pexa-6/Cerberus/Documentation/Hardware Datasheet.md

<div align="center">  
<h1>🐺 Cerberus — Hardware Datasheet</h1> 
</div>
**----------------------------------------------------------**
> Техническая документация аппаратной части проекта Cerberus. Документ описывает текущую принципиальную схему KiCad и служит справочником по питанию, интерфейсам, GPIO, резисторам и конденсаторам.

<div align="center">  
<h2>📌 Общая информация</h2> 
</div>

| **Параметр** | **Значение** |
| :---: | :---: |
| Проект | Cerberus |
| Версия документа | v0.2 |
| Статус | 🟡 Development |
| Основной контроллер | ESP32-S3-N16R8 на плате ESP32-S3-DevKitC |
| Flash | 16 MB |
| PSRAM | 8 MB |
| Логический уровень ESP32-S3 | 3.3 V |
| Основная силовая линия | +5V |
| Линия периферии | +3V3 |
| PCB | Main Board + Power Board — проектируется |
| CAD | KiCad 10 |
| Единицы измерения | mm |
| Монтажные стойки | M3 |
| Grid | 1.27 mm |

> ⚠️ В схеме используется символ `ESP32-S3-DevKitC`, а физическая плата основана на ESP32-S3-N16R8. Питание +3V3 в текущей схеме берётся с вывода 3V3 платы DevKitC; отдельный внешний стабилизатор 3.3 V на этой схеме не показан.

---

<div align="center">  
<h2>🎯 1. Назначение</h2> 
</div>
---
**Cerberus** — портативная embedded-платформа на базе ESP32-S3 с экраном, физическими кнопками, радиомодулями, RFID/NFC, инфракрасным интерфейсом и съёмным накопителем.

**Основные аппаратные узлы:**

- 🧠 ESP32-S3-N16R8 / ESP32-S3-DevKitC
- 📡 2× NRF24L01
- 📻 CC1101
- 🪪 PN532
- 🪪 RDM6300
- 🔴 IR TX на IR LED и транзисторе 2N3904
- 📥 IR RX на VS1838B
- 💾 MicroSD
- 🖥️ TFT 240×320 на ILI9341
- 🎛️ 5 физических кнопок и зуммер
- 🔋 18650 и модуль Power Bank на IP5306
- 🔌 USB и Digispark ATtiny85 как отдельный микроконтроллерный модуль

---

<div align="center">  
<h2>🧠 2. Архитектура питания</h2> 
</div>
---

```text
18650 Battery
     │
     ▼
Power Bank Module / IP5306
     │
     └────────────── +5V
                  │
	   ┌────────────┼────────────┐
       │            │            │
       ▼            ▼            ▼
    ESP32-S3    RDM6300        IR TX
     pin 5V      +5V    +5V → R8 → +5V_LED
       │
       ▼
On-board 3.3 V regulator
       │
       ▼
     +3V3
       │
       ├── NRF24L01 #1
       ├── NRF24L01 #2
       ├── CC1101
       ├── PN532
       ├── MicroSD
       ├── TFT Display
       └── VS1838B IR RX
```

<div align="center">  
<h3>2.1 Линии питания</h3> 
</div>
==================================

|  **Net** | **Напряжение** | **Назначение** |
| :---: | :---: | :---: |
|  `+BATT` | напряжение 18650 | Аккумуляторный держатель, минус батареи подключён к `-BATT` |
| `+BATT_SW` | напряжение 18650 после переключателя | Питание аккумуляторного входа Power Bank Module согласно схеме |
| `+5V` | 5 V | Выход Power Bank Module и питание 5 V потребителей |
| `+5V_LED`  | около 5 V под нагрузкой | Питание анода IR LED через R8 |
| `+3V3` | 3.3 V | Периферия с логикой 3.3 V; в текущей схеме — от вывода 3V3 DevKitC |
| `GND` | 0 V | Общая земля схемы |

> ⚠️ Перед финальной PCB необходимо проверить максимальный суммарный ток периферии и допустимый ток 3.3 V стабилизатора на используемой плате ESP32-S3-DevKitC. Наличие вывода `3V3` само по себе не гарантирует достаточный запас тока для всех радиомодулей одновременно.

---

<div align="center">  
<h2>🧩 3. SPI-архитектура</h2> 
</div>
---
В Cerberus используются **две отдельные SPI-группы**. Дисплей не входит в общую SPI-шину радиомодулей и MicroSD.

<div align="center">  
<h3>3.1 SPI Bus A — периферийная шина</h3> 
</div>
==================================
**Общие сигналы:**

| **Сигнал** | **GPIO ESP32-S3** | **Устройства** |
| :---: | :---: | :---: |
| SCK | GPIO16 | NRF24L01 #1, NRF24L01 #2, CC1101, PN532, MicroSD |
| MOSI | GPIO41 | NRF24L01 #1, NRF24L01 #2, CC1101, PN532, MicroSD |
| MISO | GPIO13 | NRF24L01 #1, NRF24L01 #2, CC1101, PN532, MicroSD |

**У каждого устройства отдельный сигнал выбора:**

| **Устройство** | **CS / CSN / SS** |
| :---: | :---: |
|  NRF24L01 #1 | GPIO48 |
|  NRF24L01 #2 | GPIO18 |
| CC1101 | GPIO38 |
| PN532 | GPIO2 |
| MicroSD | GPIO40 |

<div align="center">  
<h3>3.2 SPI Bus B — TFT Display</h3> 
</div>
==================================
**Экран использует отдельные GPIO для SPI-сигналов:**

| **Сигнал дисплея** | **GPIO / Net** | **Примечание** |
| :---: | :---: | :---: |
| CS | GPIO10 | Выбор дисплея |
| RESET | `RST` | Подключён к сети `RST` на схеме, а не к отдельному GPIO |
| DC | GPIO14 | Выбор команды/данных |
| SDI / MOSI | GPIO11 | Данные к дисплею |
| SCK | GPIO12 | Тактирование дисплея |
|  LED / Backlight | GPIO15 через R3 = 100 Ω | Управление подсветкой согласно схеме |
| SDO / MISO | NC | Не подключён в текущей схеме |

Сенсорные линии модуля дисплея (`T_CLK`, `T_CS`, `T_DIN`, `T_DO`, `T_IRQ`) на текущей схеме отмечены как `NC`. Следовательно, резистивный touch-контроллер пока электрически не подключён.

> ⚠️ Не объединять GPIO11/GPIO12 дисплея с GPIO41/GPIO16 периферийной SPI-шины без отдельного изменения схемы и проверки прошивки.

---

<div align="center">  
<h2>🧠 4. ESP32-S3-N16R8</h2> 
</div>
---

| **Параметр** | **Значение** |
| :---: | :---: |
| Назначение | Главный контроллер Cerberus |
| Flash | 16 MB |
| PSRAM | 8 MB |
| Логический уровень GPIO | 3.3 V |
| Питание платы | `+5V` на вывод 5V DevKitC |
| Выход периферийного питания | `+3V3` с вывода 3V3 DevKitC |
| USB | USB-подключение платы для питания/прошивки/отладки согласно используемой DevKitC |

Контроллер отвечает за интерфейс пользователя, кнопки, работу радиомодулей, IR TX/RX, RFID/NFC, MicroSD и управление состоянием устройства.

---

<div align="center">  
<h2>📡 5. NRF24L01</h2> 
</div>
---
Количество: **2 модуля**.

### Питание и шина

```text
VCC  → +3V3
GND  → GND
SCK  → GPIO16
MOSI → GPIO41
MISO → GPIO13
```

### Линии управления

| **Сигнал** | **NRF24L01 #1** | **NRF24L01 #2** |
| :---: | :---: | :---: |
| CE | GPIO17 | GPIO21 |
| CSN | GPIO48 | GPIO18 |
| IRQ | NC | NC |

### Локальная развязка

| **Ref** | **Номинал** | **Подключение** | **Назначение** |
| :-----: | :---: | :---: | :---: |
| C3 | 22 µF | +3V3 ↔ GND | Объёмная развязка NRF24 #1 |
| C4 | 100 nF | +3V3 ↔ GND | Керамическая высокочастотная развязка NRF24 #1 |
| C5 | 22 µF | +3V3 ↔ GND | Объёмная развязка NRF24 #2 |
| C6 | 100 nF | +3V3 ↔ GND | Керамическая высокочастотная развязка NRF24 #2 |

Конденсаторы C3/C4 и C5/C6 должны располагаться около питания соответствующего модуля. Особенно важно сделать коротким путь от керамического конденсатора к VCC и GND модуля.

---

<div align="center">  
<h2>📻 6. CC1101</h2> 
</div>
---
### Подключение

| **Сигнал** | **GPIO / Net** |
| :---: | :---: |
| VCC | +3V3 |
| GND | GND |
| SCK | GPIO16 |
| MOSI | GPIO41 |
| MISO | GPIO13 |
| CSN | GPIO38 |
| GDO0 | GPIO39 |
| GDO2 | NC |

### Локальная развязка

| **Ref** | **Номинал** | **Подключение** | **Назначение** |
| :-----: | :---: | :---: | :---: |
| C7 | 10 µF | +3V3 ↔ GND | Объёмная развязка CC1101 |
| C8 | 100 nF | +3V3 ↔ GND | Керамическая высокочастотная развязка CC1101 |

---

<div align="center">  
<h2>🪪 7. PN532</h2> 
</div>
---
В текущей схеме PN532 работает по **SPI**. I²C-контакты, показанные на дополнительном разъёме модуля, отмечены как `NC`.

| **Сигнал** | **GPIO / Net** |
| :---: | :---: |
| VCC | +3V3 |
| GND | GND |
| SCK | GPIO16 |
| MOSI | GPIO41 |
| MISO | GPIO13 |
|  SS / CS | GPIO2 |
| IRQ | NC |
| RSTO | NC |

### Локальная развязка

| **Ref** | **Номинал** | **Подключение** | **Назначение** |
| :-----: | :---: | :---: | :---: |
| C9 | 10 µF | +3V3 ↔ GND | Объёмная развязка PN532 |
| C10 | 100 nF | +3V3 ↔ GND | Керамическая высокочастотная развязка PN532 |

> Перед запуском проверь переключатель режима конкретного модуля PN532: он должен быть выставлен в SPI. Не считать выводы IRQ/RSTO подключёнными — в текущей схеме они не используются.

---

<div align="center">  
<h2>💾 8. MicroSD</h2> 
</div>
---
Интерфейс: SPI Bus A.

| **Сигнал** | **GPIO / Net** |
| :---: | :---: |
| VCC | +3V3 |
| GND | GND |
| SCK | GPIO16 |
| MOSI | GPIO41 |
| MISO | GPIO13 |
| CS | GPIO40 |

### Локальная развязка

| **Ref** | **Номинал** | **Подключение** | **Назначение** |
| :-----: | :---: | :---: | :---: |
| C13 | 47 µF | +3V3 ↔ GND | Локальный запас энергии на линии MicroSD |
| C14 | 100 nF | +3V3 ↔ GND | Керамическая высокочастотная развязка MicroSD |

---

<div align="center">  
<h2>🖥️ 9. TFT Display — ILI9341</h2> 
</div>
---

| **Параметр** | **Значение** |
| :---: | :---: |
| Разрешение | 240 × 320 |
| Интерфейс дисплея  | Отдельная SPI Bus B |
| Контроллер дисплея | ILI9341 |
| Питание | +3V3 |
| Земля | GND |

### Подключение дисплея

| **Контакт** | **Подключение** |
| :---: | :---: |
| VCC | +3V3 |
| GND | GND |
| CS | GPIO10 |
| RESET | `RST` |
| DC | GPIO14 |
| SDI / MOSI | GPIO11 |
| SCK | GPIO12 |
| LED / Backlight | GPIO15 через R3 = 100 Ω |
| SDO / MISO | NC |
| T_CLK, T_CS, T_DIN, T_DO, T_IRQ | NC |

### Конденсаторы дисплея

| **Ref** | **Номинал** | **Подключение** | **Назначение** |
| :-----: | :---: | :---: | :---: |
| C1 | 10 µF | +3V3 ↔ GND | Объёмная развязка питания дисплея |
| C2 | 100 nF | +3V3 ↔ GND | Керамическая высокочастотная развязка дисплея |

> ⚠️ Линия `RESET` на чертеже подключена к сети `RST`. Перед изготовлением платы проверь, что это действительно ожидаемое поведение для выбранного TFT-модуля. Если требуется независимый сброс дисплея, понадобится отдельный GPIO.
>
> ⚠️ GPIO15 через R3 управляет входом подсветки. Перед финальной разводкой проверь документацию своего TFT-модуля: у некоторых плат уже есть собственный ограничитель тока подсветки.

---

<div align="center">  
<h2>🪪 10. RDM6300</h2> 
</div>
---
### Питание и UART

| **Сигнал**  | **Подключение** |
| :---: | :---: |
| VCC | +5V |
| GND | GND |
| TX | Через делитель R4/R5 на GPIO42 |
| RX | NC в текущей схеме |
| ANT1 / ANT2 | NC на схеме; используется антенна/катушка самого модуля согласно его конструкции |

### Согласование уровня TX

```text
RDM6300 TX
    │
  R4 1 kΩ
    │
    ├──────── GPIO42
    │
  R5 2 kΩ
    │
   GND
```

Если высокий уровень TX равен 5 V, идеальный расчёт делителя даёт:

`VGPIO = 5 V × 2 kΩ / (1 kΩ + 2 kΩ) ≈ 3.33 V`

Это позволяет снизить уровень сигнала до диапазона GPIO ESP32-S3. Перед подключением всё равно нужно подтвердить реальный уровень сигнала TX на используемом модуле.

### Конденсаторы в области +5V

| **Ref** | **Номинал** | **Подключение** | **Область схемы** |
| :-----: | :---: | :---: | :---: |
| C11 | 100 nF | +5V ↔ GND | Узел +5V рядом с RDM6300 |
| C12 | 100 nF | +5V ↔ GND | Узел +5V рядом с RDM6300 |

На схеме C11 и C12 находятся в одной области силовой линии +5V. Их окончательное физическое размещение следует подтвердить при разводке PCB, а не копировать только по положению символов на листе.

---

<div align="center">  
<h2>🔴 11. IR TX — передатчик инфракрасного сигнала</h2> 
</div>
---
IR LED управляется отдельным NPN-транзистором **Q1 = 2N3904**. Транзистор работает как нижний ключ (low-side switch).

### Цепь IR LED

```text
+5V ── R8 33 Ω ── +5V_LED ── D1 Anode
			D1 Cathode ── Q1 Collector
```

### Управление транзистором

```text
ESP32-S3 GPIO47 ── R6 330 Ω ── Q1 Base
                               │
                            R7 10 kΩ
                               │
                              GND

Q1 Emitter ── GND
```

| **Ref** | **Компонент** | **Назначение** |
| :-----: | :---: | :---: |
| D1 | IR LED TX | Инфракрасный светодиод |
| Q1 | 2N3904 | Нижний ключ для IR LED |
| R6 | 330 Ω | Ограничение тока базы от GPIO47 |
| R7 | 10 kΩ | Подтяжка базы к GND, удерживает транзистор закрытым при старте |
| R8 | 33 Ω | Последовательный резистор между +5V и линией +5V_LED |
| C17 | 100 µF | Объёмная ёмкость в области питания IR TX |
| C18 | 100 nF | Керамическая развязка линии +5V в области IR TX |

### Важная проверка выводов 2N3904

По символу `Q1` на текущей схеме KiCad:

| **Номер вывода символа** | **Подключение на схеме** | **Функция для показанного символа** |
| :---: | :---: | :---: |
| 1 | GND | Emitter |
| 2 | Узел GPIO47/R6/R7 | Base |
| 3 | Катод D1 / net `Q1` | Collector |

**Перед изготовлением PCB обязательно проверь pinout именно того корпуса 2N3904, который будешь покупать, и сопоставь его с footprint KiCad.** Нумерацию выводов нельзя переносить по памяти с другого транзистора или корпуса.

> R8 = 33 Ω задаёт ток цепи IR LED вместе с прямым напряжением светодиода и падением напряжения на транзисторе. Перед длительной передачей проверь расчётный ток и допустимую мощность резистора по характеристикам конкретного IR LED.

---

<div align="center">  
<h2>📥 12. IR RX — приёмник VS1838B</h2> 
</div>
---

| **Контакт** | **Подключение** |
| :---: | :---: |
| VCC | +3V3 |
| GND | GND |
| OUT | GPIO1 через R2 = 100 Ω |

### Развязка питания

| **Ref** | **Номинал** | **Подключение** | **Назначение** |
| :-----: | :---: | :---: | :---: |
| C15 | 4.7 µF | +3V3 ↔ GND | Локальная объёмная развязка VS1838B |
| C16 | 100 nF | +3V3 ↔ GND | Керамическая высокочастотная развязка VS1838B |

R2 = 100 Ω стоит последовательно в сигнальной линии OUT перед GPIO1.

---

<div align="center">  
<h2>🧷 13. Digispark ATtiny85</h2> 
</div>
---
На плате предусмотрен отдельный модуль **Digispark ATtiny85**.

- Это самостоятельный микроконтроллерный модуль, не второй процессор ESP32.
- В текущей схеме его сигнальные выводы отмечены как `NC` — связи с GPIO ESP32-S3 и периферийной SPI-шиной не предусмотрены.
- Планируемое назначение — отдельные эксперименты с USB HID и автоматизацией ввода в собственной тестовой среде.
- USB-подключение Digispark не следует считать подключённым через ESP32-S3: его путь питания/USB должен рассматриваться отдельно от основной схемы Cerberus.

> Если позже решишь подключить какие-либо выводы ATtiny85 к основной плате, сначала добавь конкретные net labels, уровни питания и назначение каждого сигнала в KiCad и обнови этот документ.

---

<div align="center">  
<h2>🎛️ 14. Кнопки и зуммер</h2> 
</div>
---
### Кнопки

Пять кнопок подключаются между GPIO и GND. Для такого включения в прошивке обычно используется `INPUT_PULLUP`, если внешние подтягивающие резисторы не добавлены отдельно.

| **Кнопка** | **GPIO** | **Состояние при нажатии** |
| :---: | :---: | :---: |
| UP |  GPIO4 | LOW |
| DOWN |  GPIO5 | LOW |
| LEFT |  GPIO6 | LOW |
| RIGHT |  GPIO7 | LOW |
| OK |  GPIO8 | LOW |

### Зуммер

| **Узел** | **Подключение** |
| :---: | :---: |
| Сигнал зуммера | GPIO9 через R1 = 100 Ω |
| Второй контакт | GND |
| R1 | 100 Ω последовательно с управляющим сигналом |

> Перед постоянной работой проверь ток и тип зуммера. Если это зуммер с высоким током потребления, управлять им непосредственно от GPIO нельзя — потребуется транзисторный драйвер. R1 сам по себе не заменяет драйвер.

---

<div align="center">  
<h2>🔋 15. Аккумулятор и Power Bank Module</h2> 
</div>
---

| **Узел** | **Подключение по схеме** |
| :---: | :---: |
| Держатель 18650 `BAT+` | `+BATT` |
| Держатель 18650 `BAT−` | `-BATT` |
|  Вход питания модуля | `+BATT_SW` / `-BATT` согласно переключателю на схеме |
| Выход 5 V модуля | `+5V` и GND |
| ESP32-S3-DevKitC | 5V pin → +5V; 3V3 pin → +3V3 rail |

Перед сборкой перепроверь контакты `BAT+`, `BAT−`, выход 5 V и положение переключателей по фактической плате Power Bank Module. Не подключай 18650 напрямую к линии +5V.

---

<div align="center">  
<h2>🧮 16. Полный список конденсаторов</h2> 
</div>
---
Эта таблица сводит **все конденсаторы C1–C22, показанные на текущей схеме**. Номинал и net взяты с чертежа; назначение описывает планируемую функцию и не заменяет проверку после разводки.

| **Ref** | **Номинал** | **Линия**  | **Область / модуль** | **Тип для сборки** |
| :-----: | :---: | :---: | :---: | :---: |
| C1 | 10 µF | +3V3 ↔ GND | TFT Display | Полярный bulk-конденсатор; проверить выбранный корпус/BOM |
| C2 | 100 nF | +3V3 ↔ GND | TFT Display | Керамический, неполярный |
| C3 | 22 µF | +3V3 ↔ GND | NRF24L01 #1 | Полярный bulk-конденсатор |
| C4 | 100 nF | +3V3 ↔ GND | NRF24L01 #1 | Керамический, неполярный |
| C5 | 22 µF | +3V3 ↔ GND | NRF24L01 #2 | Полярный bulk-конденсатор |
| C6 | 100 nF | +3V3 ↔ GND | NRF24L01 #2 | Керамический, неполярный |
| C7 | 10 µF | +3V3 ↔ GND | CC1101 | Полярный bulk-конденсатор |
| C8 | 100 nF | +3V3 ↔ GND | CC1101 | Керамический, неполярный |
| C9 | 10 µF | +3V3 ↔ GND | PN532 | Полярный bulk-конденсатор |
| C10 | 100 nF | +3V3 ↔ GND | PN532 | Керамический, неполярный |
| C11 | 100 nF | +5V ↔ GND  | Узел +5V, область RDM6300 | Керамический, неполярный |
| C12 | 100 nF | +5V ↔ GND  | Узел +5V, область RDM6300 | Керамический, неполярный |
| C13 | 47 µF | +3V3 ↔ GND | MicroSD | Полярный bulk-конденсатор |
| C14 | 100 nF | +3V3 ↔ GND | MicroSD | Керамический, неполярный |
| C15 | 4.7 µF | +3V3 ↔ GND | VS1838B / IR RX | Полярный bulk-конденсатор |
| C16 | 100 nF | +3V3 ↔ GND | VS1838B / IR RX | Керамический, неполярный |
| C17 | 100 µF | +5V ↔ GND  | Узел питания IR TX | Полярный bulk-конденсатор |
| C18 | 100 nF | +5V ↔ GND  | Узел питания IR TX | Керамический, неполярный |
| C19 | 470 µF | +5V ↔ GND  | Главная линия +5V возле ESP32-S3 | Полярный bulk-конденсатор |
| C20 | 100 nF | +5V ↔ GND  | Главная линия +5V возле ESP32-S3 | Керамический, неполярный |
| C21 | 100 nF | +3V3 ↔ GND | Линия +3V3 возле ESP32-S3 | Керамический, неполярный |
| C22 | 100 nF | +3V3 ↔ GND | Линия +3V3 возле ESP32-S3 | Керамический, неполярный |

<div align="center">  
<h3>16.1 Правила установки конденсаторов</h3> 
</div>
==================================
- Керамический `100 nF` устанавливай максимально близко к питанию соответствующего модуля; соединения VCC–C–GND должны быть короткими.
- Bulk-конденсатор `4.7–470 µF` располагается рядом с модулем/ветвью питания, которой он помогает.
- Полярный конденсатор: `+` к положительной линии, `−` к GND. Перед пайкой проверь метку минуса на корпусе.
- Керамические конденсаторы неполярные.
- Электрическое подключение в каждой паре параллельное: оба конденсатора идут между одной линией питания и GND, а не последовательно друг с другом.
- Положение символов на принципиальной схеме не задаёт реальное расстояние на PCB. Размещай детали физически у выводов питания конкретного модуля.
- Номиналы в этой таблице отражают текущую схему Cerberus. До заказа платы их следует сверить с datasheet модулей и финальной BOM.

==================================

---

<div align="center">  
<h2>🧮 17. Полный список резисторов</h2> 
</div>
---

| **Ref** | **Номинал** | **Подключение** | **Назначение** |
| :-----: | :---: | :---: | :---: |
| R1 | 100 Ω | GPIO9 → зуммер |  Последовательный резистор управляющей линии зуммера  |
| R2 | 100 Ω | VS1838B OUT → GPIO1 | Последовательный резистор сигнала IR RX |
| R3 | 100 Ω | GPIO15 → LED/Backlight TFT | Последовательный резистор управляющей линии подсветки |
| R4 | 1 kΩ |  RDM6300 TX → узел GPIO42  | Верхний резистор делителя уровня UART |
| R5 | 2 kΩ | Узел GPIO42 → GND | Нижний резистор делителя уровня UART |
| R6 | 330 Ω | GPIO47 → база Q1 | Ограничение тока базы 2N3904 |
| R7 | 10 kΩ | База Q1 → GND | Подтяжка базы к GND / pull-down |
| R8 | 33 Ω | +5V → +5V_LED | Последовательный резистор в цепи питания IR LED |

> Номиналы R1–R8 перепроверить по фактическим компонентам перед сборкой. Особенно важны мощность R8 и ток IR LED, pinout Q1 и ток зуммера.

---

<div align="center">  
<h2>🧠 18. GPIO Allocation</h2> 
</div>
---

| **GPIO** | **Назначение** | **Интерфейс / цепь** | **Статус по схеме** |
| :---: | :---: | :---: | :---: |
|  GPIO1 | IR RX | VS1838B OUT через R2 = 100 Ω | Подключён |
|  GPIO2 | PN532 CS / SS | SPI Bus A | Подключён |
|  GPIO4 | UP | Кнопка на GND | Подключён |
|  GPIO5 | DOWN | Кнопка на GND | Подключён |
|  GPIO6 | LEFT | Кнопка на GND | Подключён |
|  GPIO7 | RIGHT | Кнопка на GND | Подключён |
|  GPIO8 | OK | Кнопка на GND | Подключён |
|  GPIO9 | Buzzer | Через R1 = 100 Ω | Подключён |
|  GPIO10  | TFT CS | SPI Bus B | Подключён |
|  GPIO11  | TFT SDI / MOSI | SPI Bus B | Подключён |
|  GPIO12  | TFT SCK | SPI Bus B | Подключён |
|  GPIO13  | MISO | SPI Bus A | Подключён |
|  GPIO14  | TFT DC | Управление дисплеем | Подключён |
|  GPIO15  | TFT LED / Backlight | Через R3 = 100 Ω | Подключён |
|  GPIO16  | SCK | SPI Bus A | Подключён |
|  GPIO17  | NRF24L01 #1 CE | Управление радио | Подключён |
|  GPIO18  | NRF24L01 #2 CSN | SPI CS | Подключён |
|  GPIO21  | NRF24L01 #2 CE | Управление радио | Подключён |
|  GPIO38  | CC1101 CSN | SPI CS | Подключён |
|  GPIO39  | CC1101 GDO0 | Digital | Подключён |
|  GPIO40  | MicroSD CS | SPI CS | Подключён |
|  GPIO41  | MOSI | SPI Bus A | Подключён |
|  GPIO42  | RDM6300 TX | Через делитель R4/R5 | Подключён |
|  GPIO47  | IR TX | Через R6 = 330 Ω на базу Q1  | Подключён |
|  GPIO48  | NRF24L01 #1 CSN | SPI CS | Подключён |

<div align="center">  
<h2>18.1 Сигналы, которые сейчас не используются</h2> 
</div>
==================================
- IRQ у обоих NRF24L01.
- GDO2 CC1101.
- IRQ и RSTO PN532.
- SDO/MISO TFT и все touch-сигналы TFT.
- RX RDM6300.
- Выводы Digispark ATtiny85, отмеченные NC на текущей схеме.

==================================

---

<div align="center">  
<h2>📐 19. Правила PCB</h2> 
</div>
---
### Питание и земля

- Делай короткими пути от каждого конденсатора `100 nF` до VCC/GND соответствующего модуля.
- Для полярных конденсаторов обязательно обозначь полярность на шелкографии.
- Проверь ширину дорожек +5V и GND по максимальному току.
- Следи за допустимым током линии +3V3, получаемой с DevKitC.
- Ветка IR LED несёт импульсный ток; не прокладывай её так, чтобы она создавала лишние помехи в чувствительных сигнальных цепях.

### SPI

- SPI Bus A (`GPIO16`, `GPIO41`, `GPIO13`) — NRF24, CC1101, PN532, MicroSD.
- SPI Bus B (`GPIO12`, `GPIO11`) — только TFT-дисплей в текущей версии схемы.
- Каждое SPI-устройство на Bus A имеет собственный CS/CSN/SS.
- Не подключай одновременно выходы MISO нескольких устройств, если их CS не обеспечивает корректное отключение выхода.

### RF

- Располагай радиомодули так, чтобы антеннам хватало свободного пространства.
- Соблюдай ограничения производителя модуля по меди и компонентам под антенной.
- Старайся отделять антенны и RF-часть от импульсных силовых цепей и линий IR TX.

---

<div align="center">  
<h2>🧪 20. Hardware Testing</h2> 
</div>
---
Статус здесь отражает только уже проведённые тесты и известные результаты; он не равен полной проверке всей функции модуля.

| **Модуль** | **Проверка** | **Статус** |
| :---: | :---: | :---: |
| ESP32-S3 | Boot / USB / Serial | 🟢 Проверено |
| TFT ILI9341 | Вывод изображения | 🟢 Проверено |
| Кнопки | Ввод в прошивке | 🟢 Проверено |
| NRF24L01 #1 | SPI-инициализация | 🟢 Проверено |
| NRF24L01 #2 | SPI-инициализация | 🟢 Проверено |
| CC1101 | Чтение регистров | 🟡 Требует повторной проверки: раньше ответа не было |
| PN532 | SPI / чтение карты | 🟢 Проверено |
| RDM6300 | UART / RFID | 🟢 Проверено |
| IR TX | Включение драйвера | 🟢 Проверено |
| IR RX | Получение сигнала | 🟢 Проверено |
| MicroSD | Чтение / запись | 🟢 Проверено |
| Зуммер | Звуковой сигнал | 🟢 Проверено |
| Digispark ATtiny85 | Отдельная работа | ⚪ Не относится к связям ESP32 на текущей схеме |
| Power Bank / силовые линии | Работа под максимальной нагрузкой | 🟡 Требуется измерить токи и просадки напряжения |

---

<div align="center">  
<h2>📋 21. Hardware Status</h2> 
</div>
---
### 🟢 Подключения, отражённые на схеме

- Основной ESP32-S3-DevKitC / ESP32-S3-N16R8.
- Отдельная SPI Bus A для NRF24, CC1101, PN532 и MicroSD.
- Отдельная SPI Bus B для TFT.
- IR TX на 2N3904 с R6 = 330 Ω, R7 = 10 kΩ и R8 = 33 Ω.
- IR RX на VS1838B с R2 = 100 Ω.
- RDM6300 с делителем R4 = 1 kΩ / R5 = 2 kΩ.
- 5 кнопок и зуммер.
- Конденсаторы C1–C22 и резисторы R1–R8 внесены в таблицы этого документа.

### 🟡 Требует проверки до изготовления PCB

- Максимальный суммарный ток линии +3V3.
- Распиновка и footprint конкретного 2N3904.
- Ток IR LED и рассеиваемая мощность R8 = 33 Ω.
- Нужен ли отдельный GPIO для RESET TFT вместо сети `RST`.
- Подсветка TFT с учётом наличия/отсутствия штатного резистора на самом модуле.
- Физическое расположение C11/C12 и других конденсаторов на PCB.
- Успешная работа CC1101, PN532 и MicroSD в окончательной сборке.

---

<div align="center">  
<h2>📚 22. References</h2> 
</div>
---
Для финального уточнения параметров использовать datasheet именно тех модулей и компонентов, которые установлены в Cerberus:

- ESP32-S3-DevKitC / ESP32-S3-N16R8 documentation
- ESP32-S3 Datasheet и Hardware Design Guidelines
- NRF24L01(+) Datasheet
- CC1101 Datasheet
- PN532 User Manual / Datasheet
- RDM6300 module documentation
- ILI9341 Datasheet и документация платы TFT
- VS1838B Datasheet
- MicroSD card/module documentation
- 2N3904 Datasheet для конкретного производителя и корпуса
- IP5306 / Power Bank Module documentation

---

<div align="center">  
<h2>🔄 23. Revision History</h2> 
</div>
---

| **Версия** | **Дата** | **Изменения** |
| --- | --- | --- |
| v0.1 | 2026-10-07 | Первичная версия документа |
| v0.2 | 2026-10-11 | Разделены SPI Bus A и SPI Bus B; обновлены TFT, PN532, Digispark ATtiny85, IR TX на 2N3904; добавлены C1–C22 и R1–R8 по текущей схеме KiCad |

---

**----------------------------------------------------------**
