pexa-6/Cerberus/Documentation/Firmware Documentation.md

<div align="center">  
<h1>🐺 Cerberus — Firmware Documentation</h1> 
</div>
**----------------------------------------------------------**

---

---

**----------------------------------------------------------**
