pexa-6/Cerberus/Test/Art.png

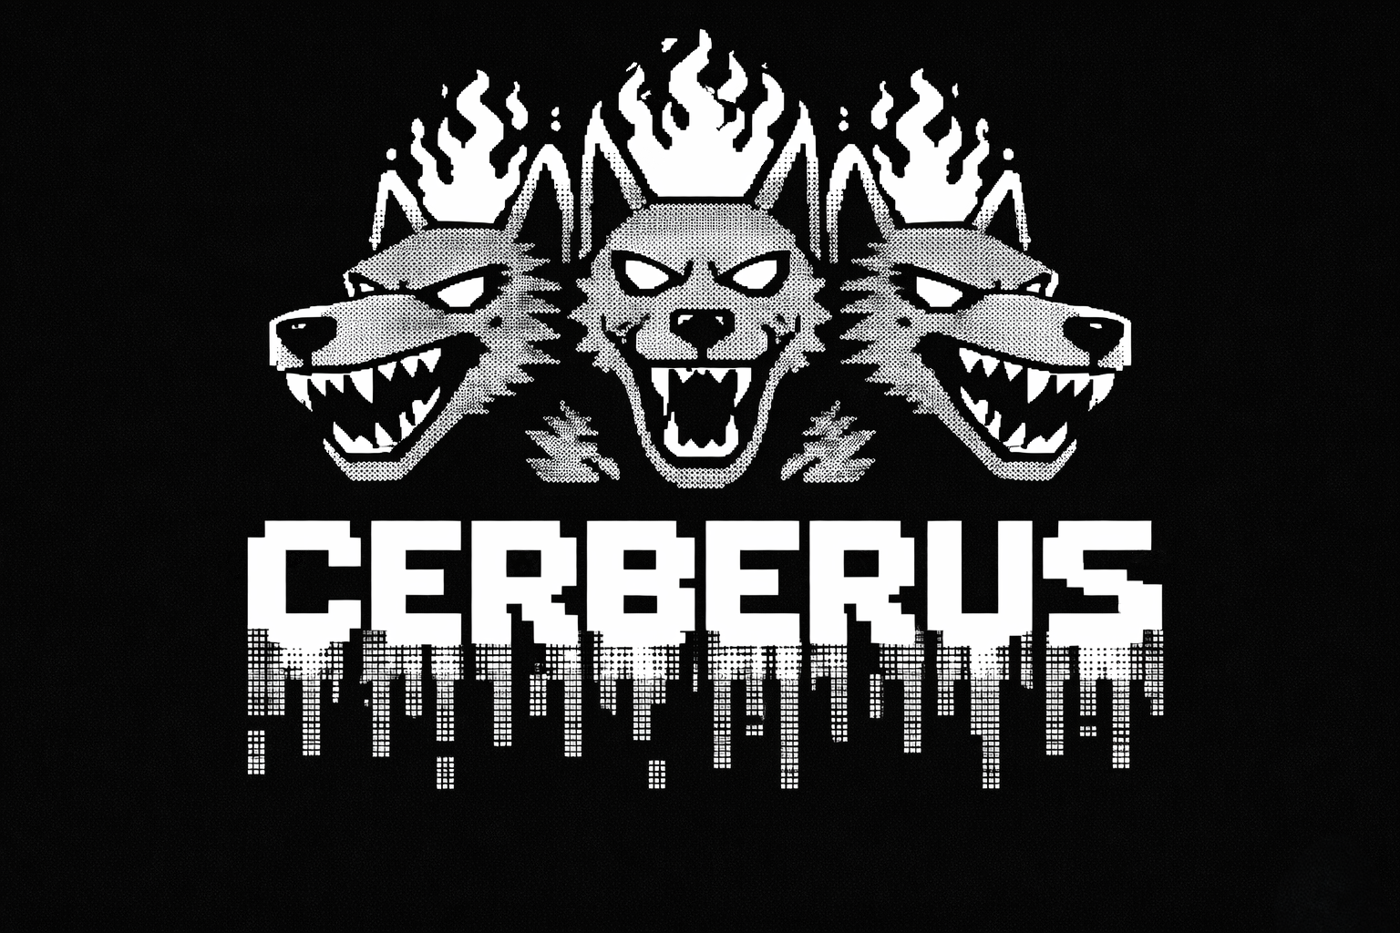
Test/Art.png
