pexa-6/Cerberus/Test/Cerberus.png

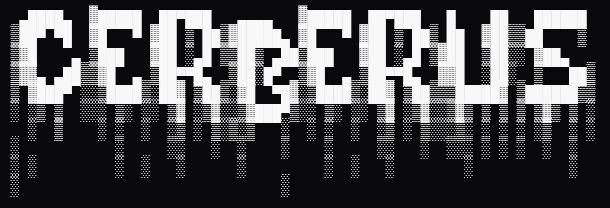
Test/Cerberus.png
