pexa-6/Cerberus/KiCad/Cerberus.kicad_sch

## KiCad design KiCad/Cerberus.kicad_sch (2026-10-11)

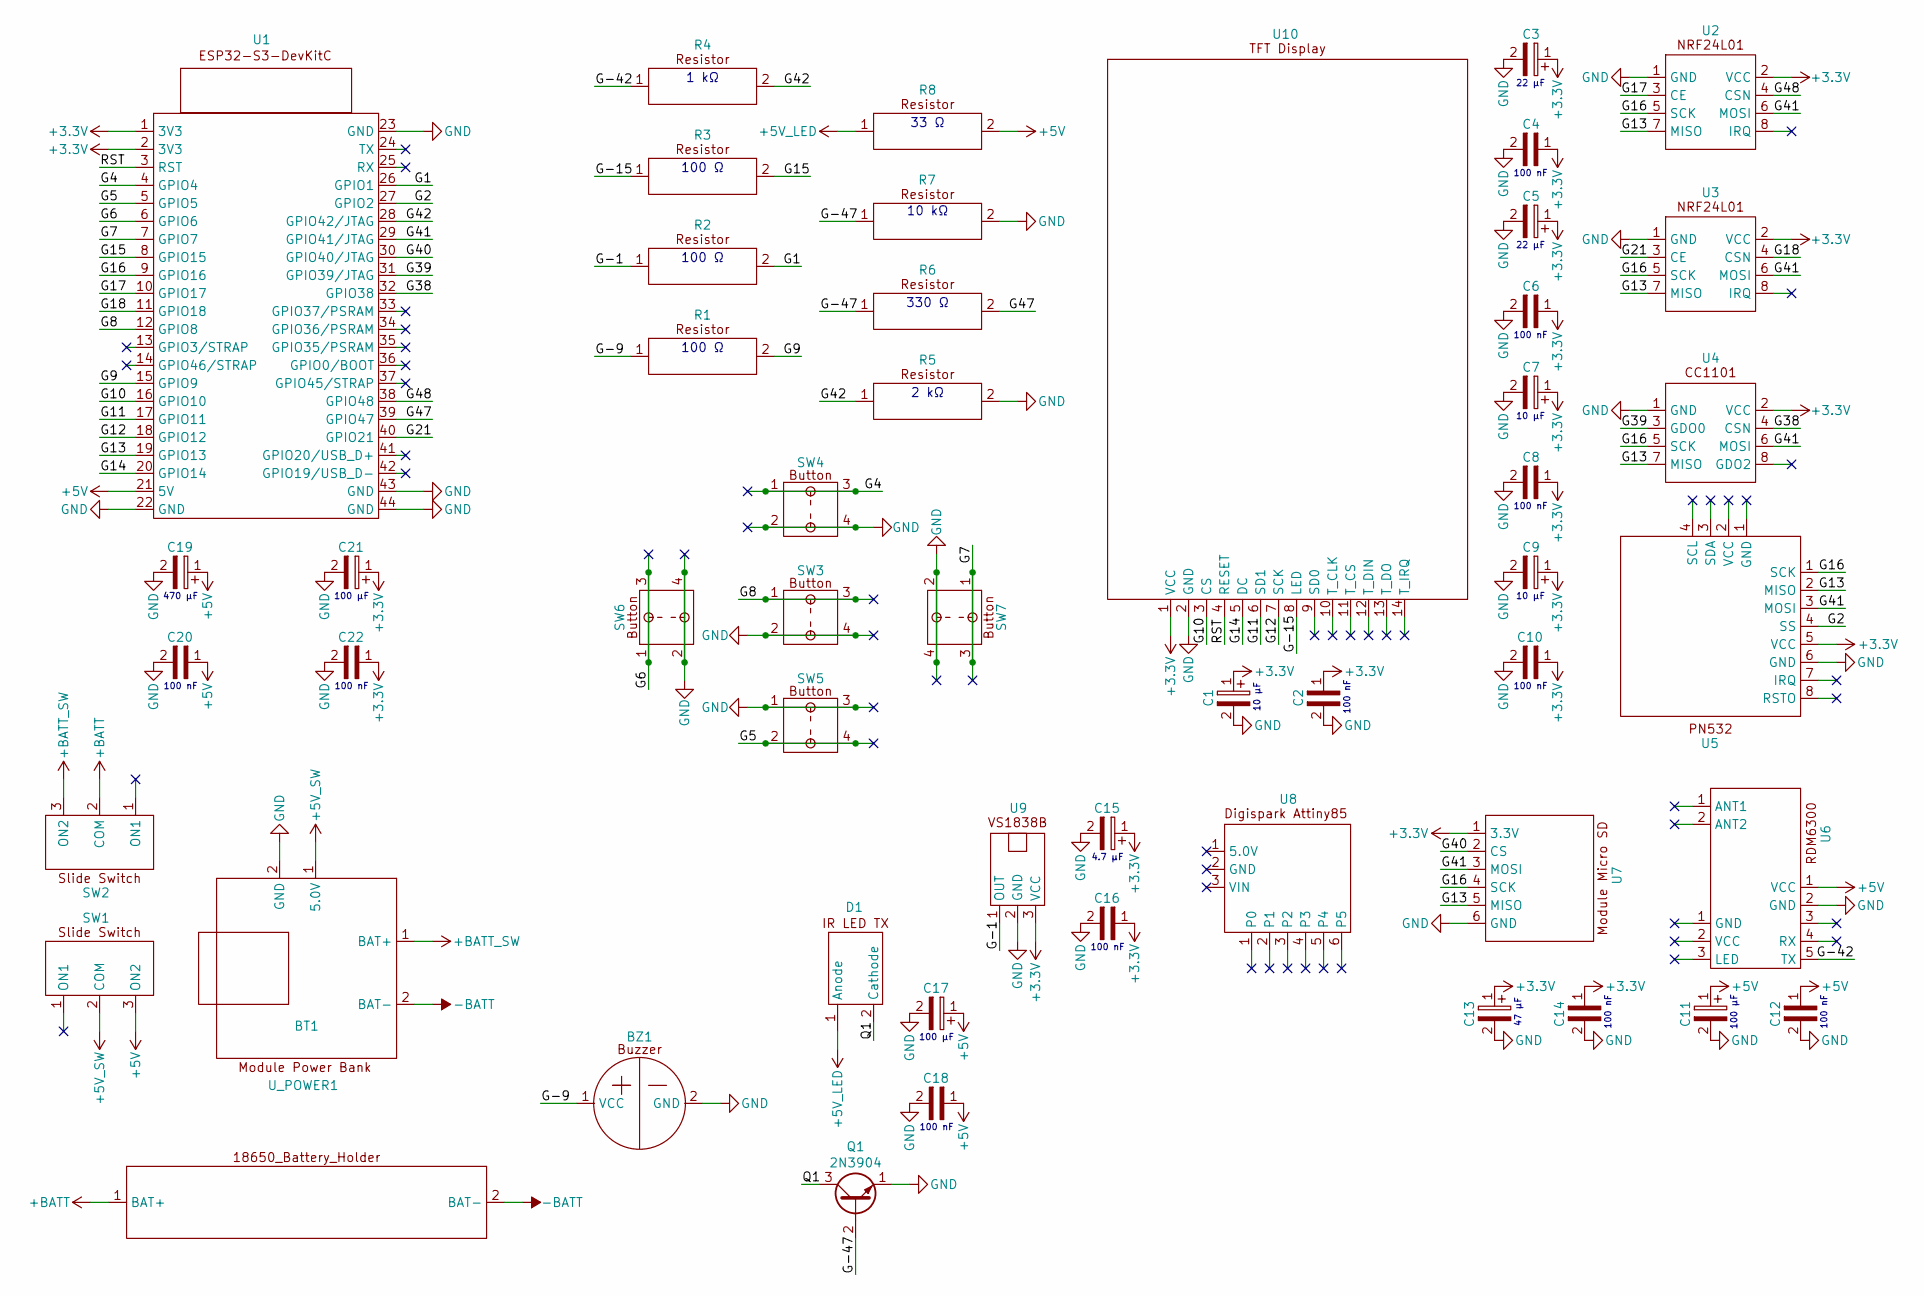
[picture p3: schematic Cerberus.kicad_sch]

Parts:
BT1: 18650_Battery_Holder
BZ1: Buzzer
C1, C3, C5, C7, C9, C11, C13, C15, C17, C21: C_Electrolytic
C2, C4, C6, C8, C10, C12, C14, C16, C18, C20, C22: C_Ceramic
C19: C_Electrolytic_470
D1: IR_LED_TX
Q1: 2N3904; TO-92_Inline
R1, R2, R3, R4, R5, R6, R7, R8: Resistor
SW1, SW2: Slide_Switch
SW3, SW4, SW5, SW6, SW7: Button
U1: ESP32-S3-DevKitC
U2, U3: NRF24L01
U4: CC1101
U5: PN532
U6: RDM6300
U7: Module_Micro_SD
U8: Digispark_Attiny85
U9: VS1838B
U10: TFT_Display
U_POWER1: Module_Power_Bank

Connections:
+3.3V: C1.1, C2.1, C3.1, C4.1, C5.1, C6.1, C7.1, C8.1, C9.1, C10.1, C13.1, C14.1, C15.1, C16.1, C21.1, C22.1, U1.1 (3V3), U1.2 (3V3), U2.2 (VCC), U3.2 (VCC), U4.2 (VCC), U5.5 (VCC), U7.1 (3.3V), U9.3 (VCC), U10.1 (VCC)
+5V: C11.1, C12.1, C17.1, C18.1, C19.1, C20.1, R8.2, SW1.3 (ON2), U1.21 (5V), U6.1 (ANT1)
+5V_LED: D1.1 (Anode), R8.1
+5V_SW: SW1.2 (COM), U_POWER1.1 (5.0V)
+BATT: BT1.1 (BAT+), SW2.2 (COM)
+BATT_SW: SW2.3 (ON2), U_POWER1.1 (5.0V)
-BATT: BT1.2 (BAT-), U_POWER1.2 (GND)
G1: R2.2, U1.26 (GPIO1)
G2: U1.27 (GPIO2), U5.4 (SCL)
G4: SW4.1, SW4.3, U1.4 (GPIO4)
G5: SW5.2, SW5.4, U1.5 (GPIO5)
G6: SW6.1, SW6.3, U1.6 (GPIO6)
G7: SW7.1, SW7.3, U1.7 (GPIO7)
G8: SW3.1, SW3.3, U1.12 (GPIO8)
G9: R1.2, U1.15 (GPIO9)
G10: U1.16 (GPIO10), U10.3 (CS)
G11: U1.17 (GPIO11), U10.6 (SD1)
G12: U1.18 (GPIO12), U10.7 (SCK)
G13: U1.19 (GPIO13), U2.7 (MISO), U3.7 (MISO), U4.7 (MISO), U5.2 (VCC), U7.5 (MISO)
G14: U1.20 (GPIO14), U10.5 (DC)
G15: R3.2, U1.8 (GPIO15)
G16: U1.9 (GPIO16), U2.5 (SCK), U3.5 (SCK), U4.5 (SCK), U5.1 (GND), U7.4 (SCK)
G17: U1.10 (GPIO17), U2.3 (CE)
G18: U1.11 (GPIO18), U3.4 (CSN)
G21: U1.40 (GPIO21), U3.3 (CE)
G38: U1.32 (GPIO38), U4.4 (CSN)
G39: U1.31 (GPIO39/JTAG), U4.3 (GDO0)
G40: U1.30 (GPIO40/JTAG), U7.2 (CS)
G41: U1.29 (GPIO41/JTAG), U2.6 (MOSI), U3.6 (MOSI), U4.6 (MOSI), U5.3 (SDA), U7.3 (MOSI)
G42: R4.2, R5.1, U1.28 (GPIO42/JTAG)
G47: R6.2, U1.39 (GPIO47)
G48: U1.38 (GPIO48), U2.4 (CSN)
G-1: R2.1, U9.1 (OUT)
G-9: BZ1.1 (VCC), R1.1
G-15: R3.1, U10.8 (LED)
G-42: R4.1, U6.5 (TX)
G-47: Q1.2 (B), R6.1, R7.1
GND: BZ1.2 (GND), C1.2, C2.2, C3.2, C4.2, C5.2, C6.2, C7.2, C8.2, C9.2, C10.2, C11.2, C12.2, C13.2, C14.2, C15.2, C16.2, C17.2, C18.2, C19.2, C20.2, C21.2, C22.2, Q1.1 (E), R5.2, R7.2, SW3.2, SW3.4, SW4.2, SW4.4, SW5.1, SW5.3, SW6.2, SW6.4, SW7.2, SW7.4, U1.22 (GND), U1.23 (GND), U1.43 (GND), U1.44 (GND), U2.1 (GND), U3.1 (GND), U4.1 (GND), U5.6 (GND), U6.2 (ANT2), U7.6 (GND), U9.2 (GND), U10.2 (GND), U_POWER1.2 (GND)
Q1: D1.2 (Cathode), Q1.3 (C)
RST: U1.3 (RST), U10.4 (RESET)

Notes on the sheet:
10 µF
100 nF
100 Ω
330 Ω
100 µF
10 kΩ
22 µF
2 kΩ
1 kΩ
47 µF
4.7 µF
470 µF
33 Ω
