pexa-6/Cerberus/Firmware/src/bus.h

#pragma once
#include <SPI.h>

// Общая SPI-шина для NRF24L01 x2, CC1101, PN532 и Micro SD
// (SCK16 / MOSI41 / MISO13, см. pins.h). У каждого устройства свой
// CS, шина при этом одна - см. объяснение в гайде по железу.
//
// Используется один и тот же объект radioBus всеми будущими
// модулями (Storage уже его использует для SD). Инициализируется
// один раз в radioBus_begin(), вызывать повторно не нужно и не вредно
// (SPI.begin можно звать второй раз, но лучше не плодить вызовы).

extern SPIClass radioBus;

void radioBus_begin();
