pexa-6/Cerberus/Firmware/src/ui.h

#pragma once

namespace UI {

// Рисует заставку и главное меню. Вызывается один раз из setup().
void begin();

// Опрашивает кнопки и перерисовывает экран при изменениях.
// Вызывается каждый цикл из loop().
void update();

} // namespace UI
